SystemsCyber/RemoteRudder/StepperMotorWithEncoder/IMG_7445.JPEG

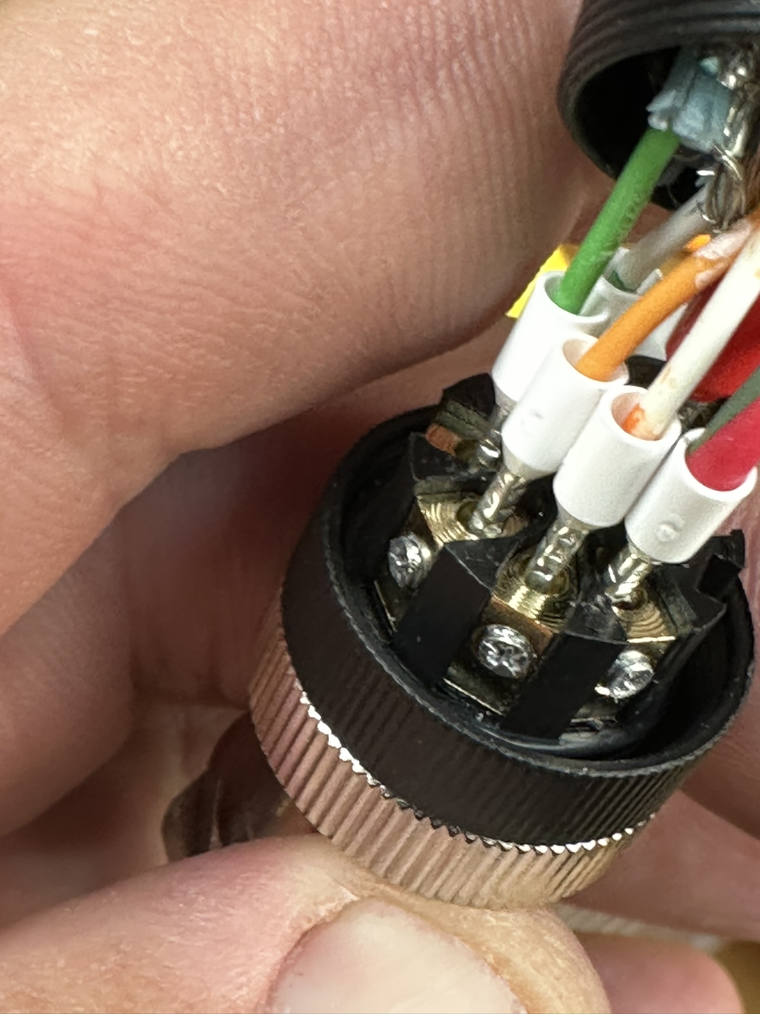
StepperMotorWithEncoder/IMG_7445.JPEG
