SystemsCyber/RemoteRudder/StepperMotorWithEncoder/IMG_7434.JPEG

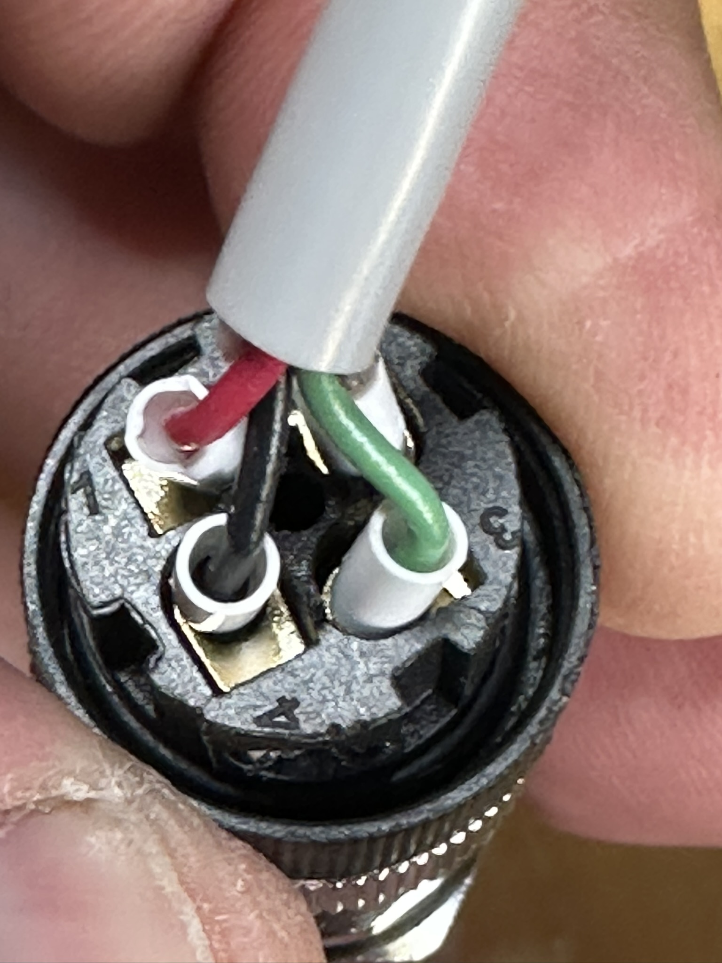
StepperMotorWithEncoder/IMG_7434.JPEG
