SystemsCyber/RemoteRudder/README.md

# RemoteRudder
 Code to control a rudder based autopilot for a ski boat
