SystemsCyber/RemoteRudder/HMI/fullturns.png

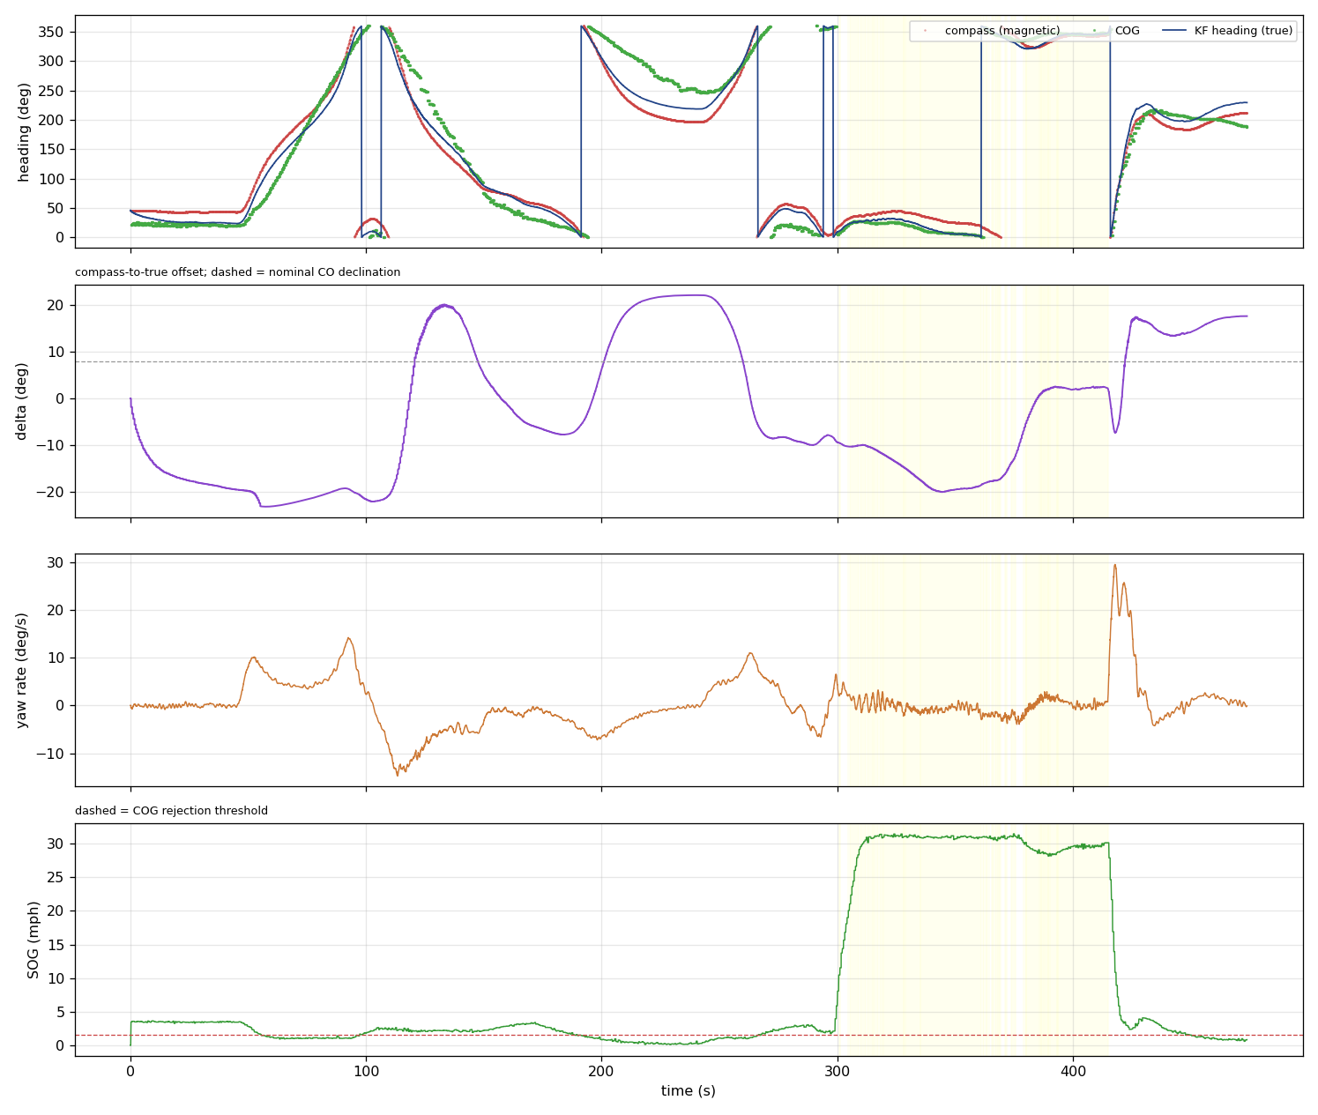
HMI/fullturns.png
