SystemsCyber/RemoteRudder/HMI/trolling.png

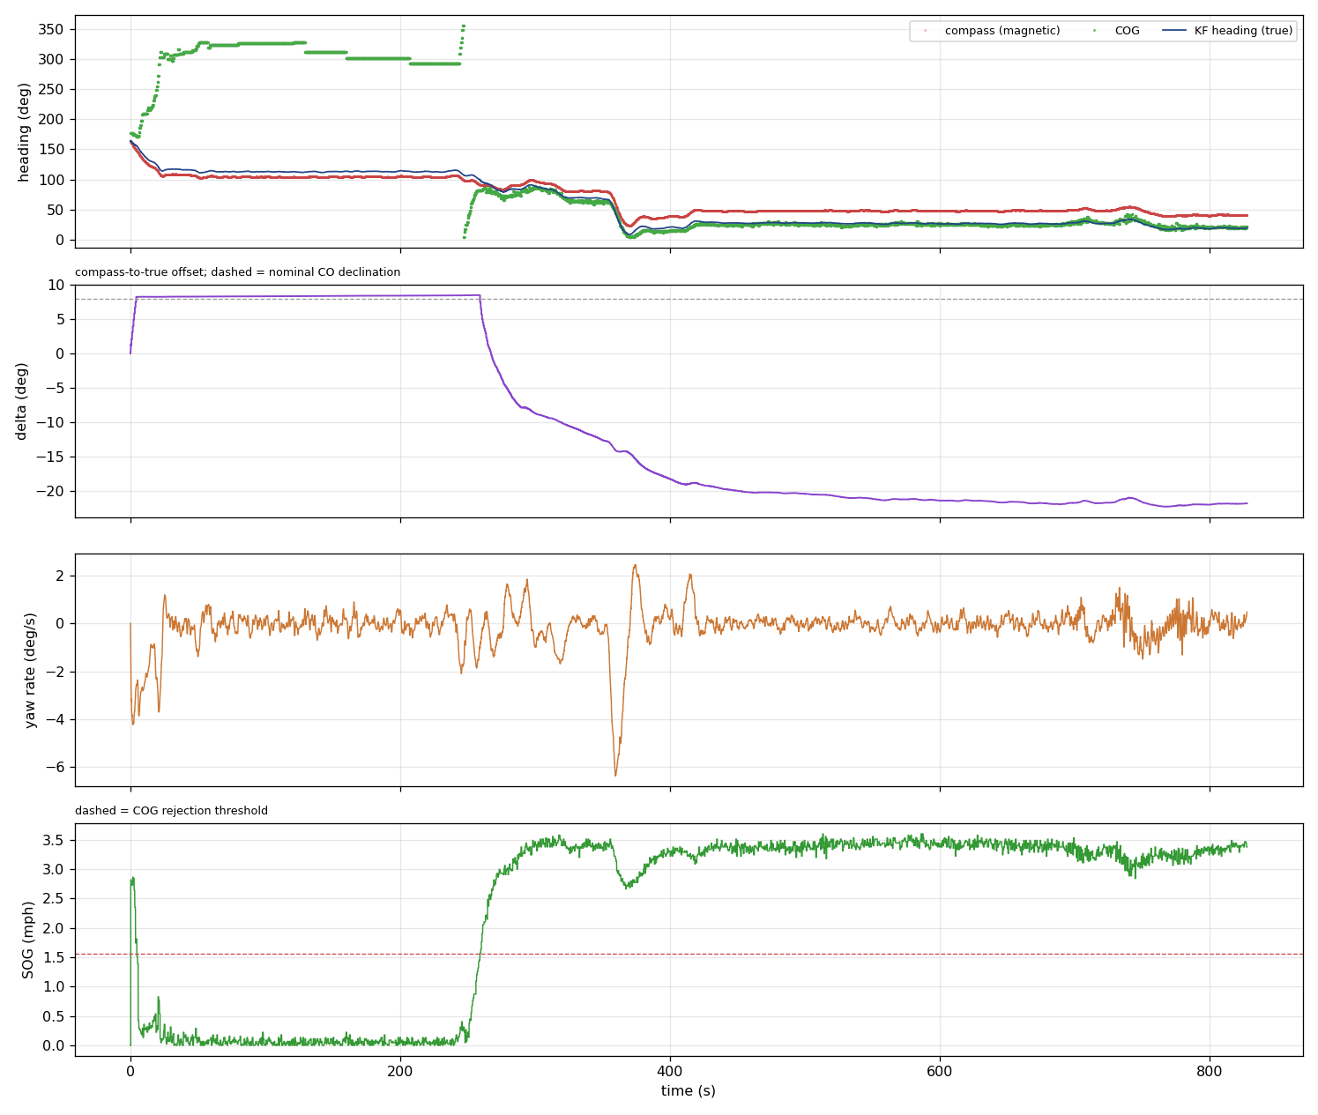
HMI/trolling.png
