SystemsCyber/RemoteRudder/sensor_node/SchematicSensorNode.png

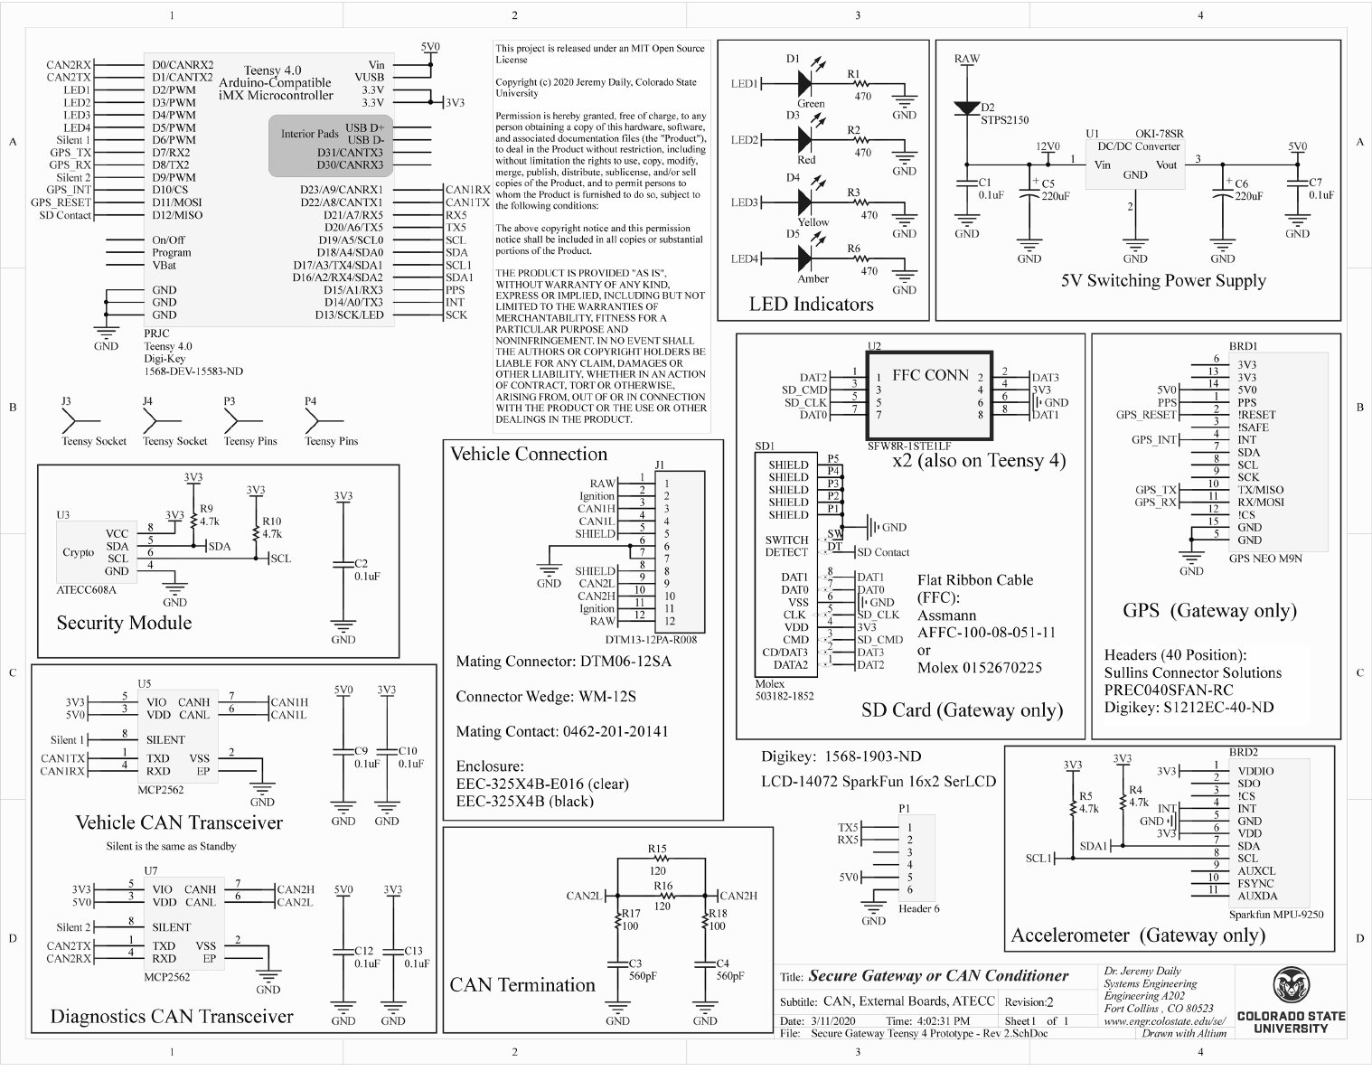
sensor_node/SchematicSensorNode.png
