SystemsCyber/RemoteRudder/StepperMotorWithEncoder/IMG_7435.JPEG

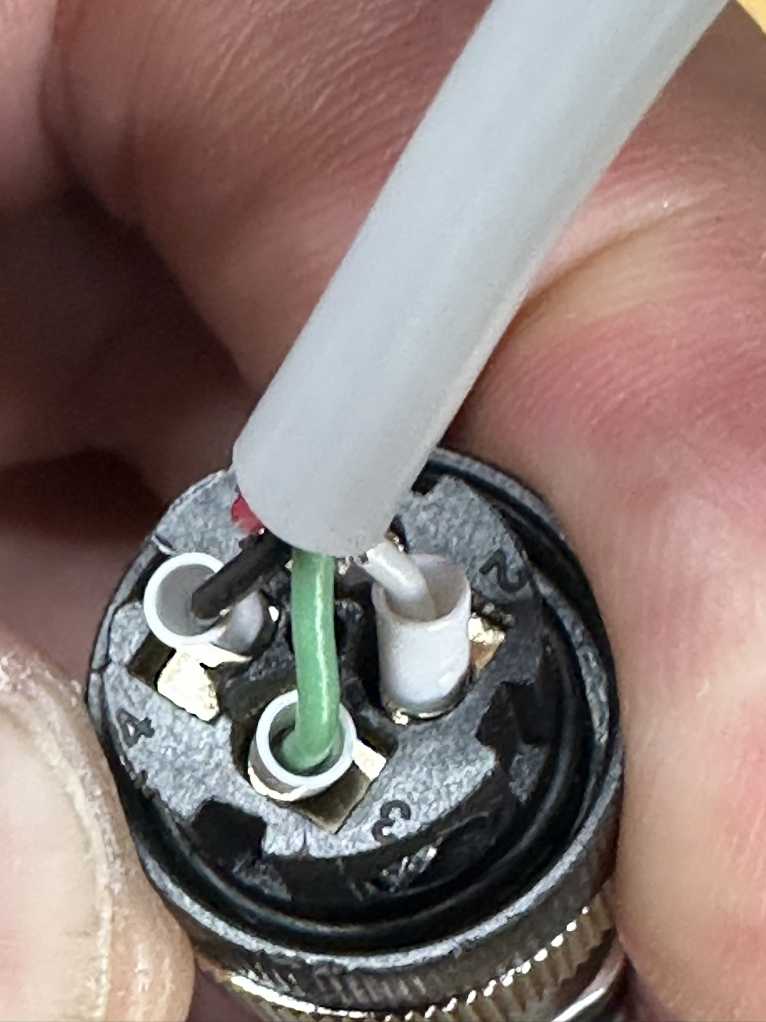
StepperMotorWithEncoder/IMG_7435.JPEG
