SystemsCyber/RemoteRudder/StepperMotorWithEncoder/IMG_7442.JPEG

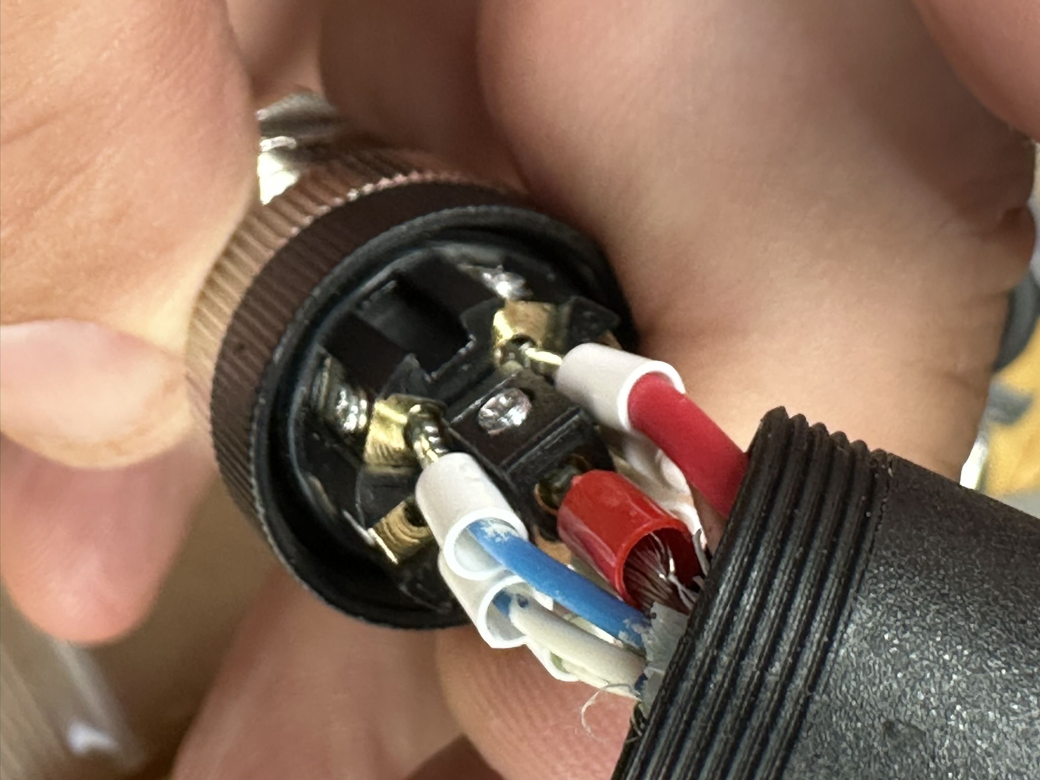
StepperMotorWithEncoder/IMG_7442.JPEG
