SystemsCyber/RemoteRudder/StepperMotorWithEncoder/IMG_7443.JPEG

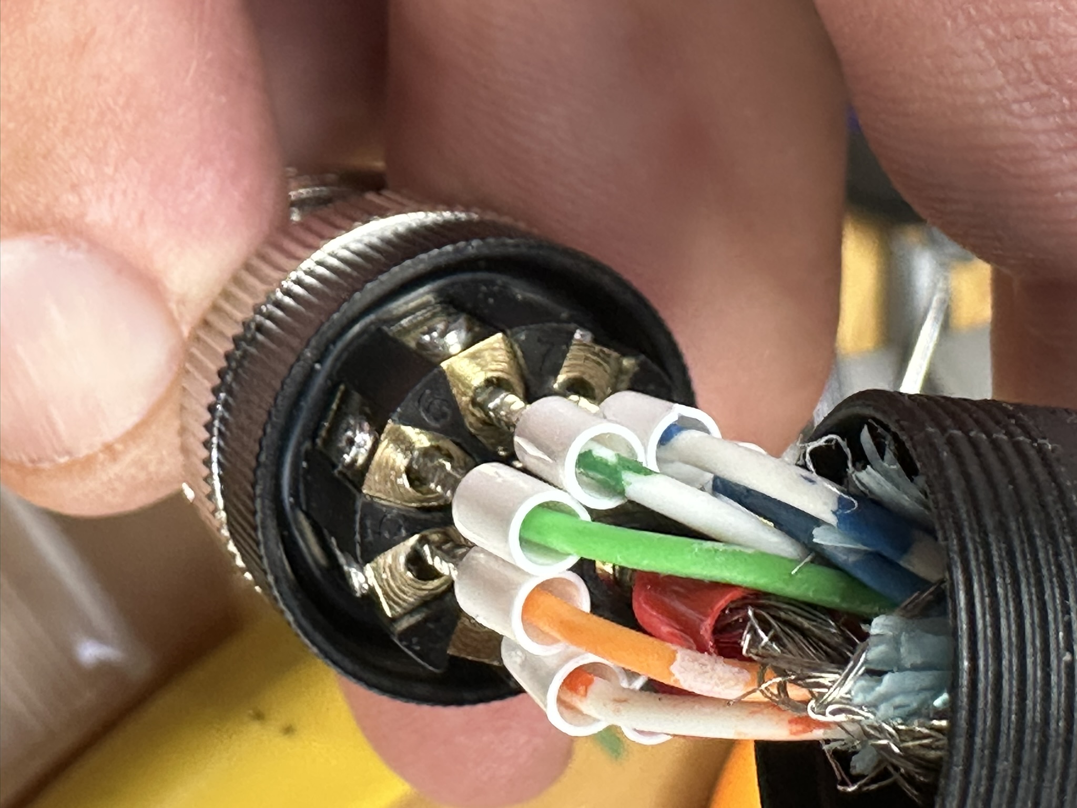
StepperMotorWithEncoder/IMG_7443.JPEG
