SystemsCyber/RemoteRudder/StepperMotorWithEncoder/IMG_7444.JPEG

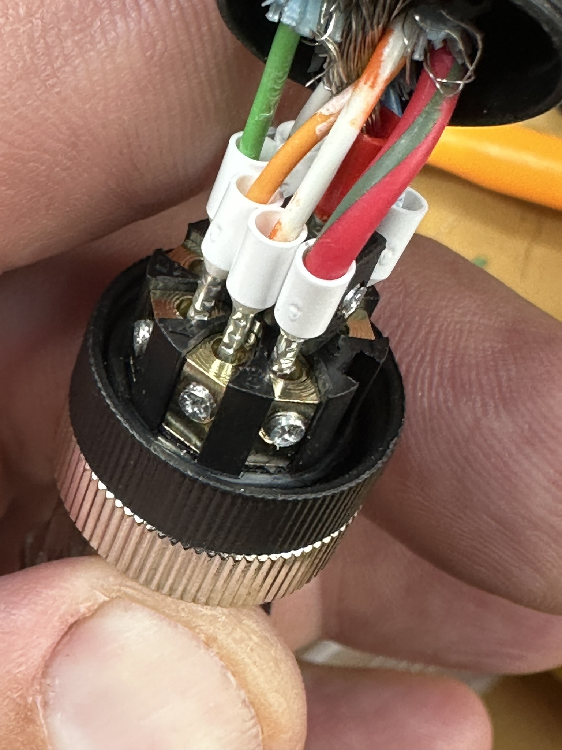
StepperMotorWithEncoder/IMG_7444.JPEG
