SystemsCyber/RemoteRudder/StepperMotorWithEncoder/IMG_7458.JPEG

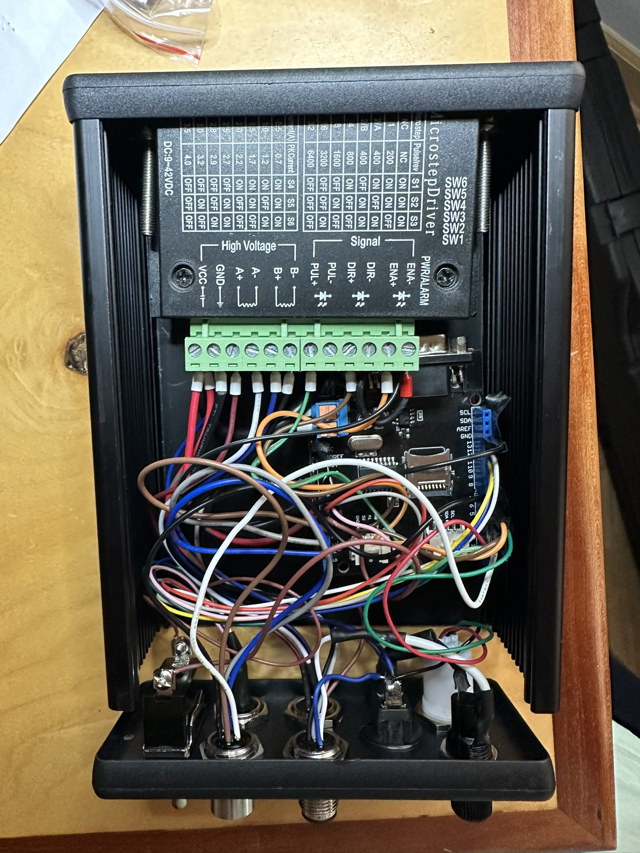
StepperMotorWithEncoder/IMG_7458.JPEG
