SystemsCyber/RemoteRudder/StepperMotorWithEncoder/IMG_7463.JPEG

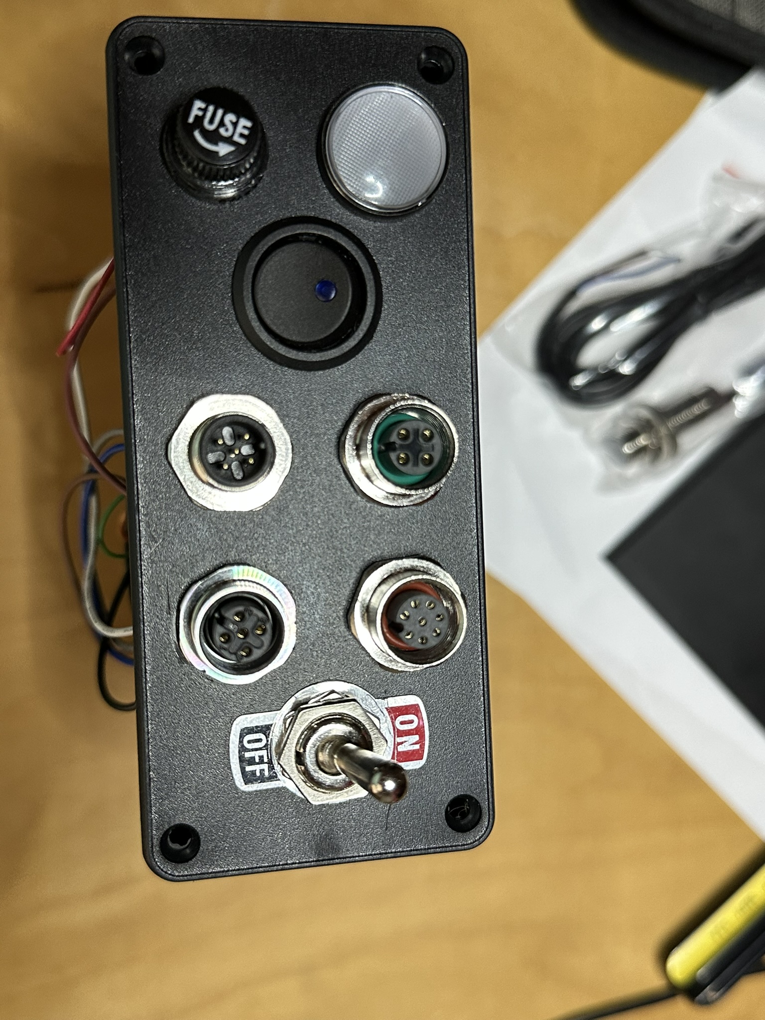
StepperMotorWithEncoder/IMG_7463.JPEG
