SystemsCyber/RemoteRudder/RudderPosition/RudderPosition.ino

/*
Rudder Sensor

The rudder sensor is based on a string potentiometer that extends and retracts with the 
steering cable. The wiper of the string pot is on A4.

Rudder PGN 127245 (0x1F10D)
Default Priority is 2
Default update rate is 100 milliseconds
Destination is Global
Source address is 19, Steering.

The hardware is a Teensy 3.6 with the following connections:
CAN1 has an MCP2562 TXRX
A7 is a red LED
A6 is a green LED
A4 is connected to the wiper of the potentiometer

*/
#include <FlexCAN_T4.h>

FlexCAN_T4<CAN1, RX_SIZE_256, TX_SIZE_16> Can1;
FlexCAN_T4<CAN0, RX_SIZE_256, TX_SIZE_16> Can0;

elapsedMillis output_timer;
const int output_period = 100; //milliseconds

// These constants won't change. They're used to give names to the pins used:
const int analogInPin = A4;  // Analog input pin that the potentiometer is attached to
const long int priority_part = 0x18000000; //Priority 6
const long int pgn_part = 0x01F10D00; //NMEA 2000
const long int source_part = 19; //J1939 SA

const long int CAN_ID = priority_part + pgn_part + source_part;

// NMEA2000 Fields

//Field 1
uint8_t rudder_instance = 0; //Tells which instance of the rudder we are using. 0 = only one.

//Field 2 and 3
uint8_t direction_order = 0b11111111; //Not available

//Field 4
int16_t angle_order = 0xFFFF; //Not available as a command

//Field 5
// Rudder angle where positive values are starboard and negative values are port.
int16_t rudder_position = 0; //range +/1 Pi rad, resolution 1e-4 rad

int sensorValue = 256;        // value read from the pot
int rudder_angle_rad = 0;   // value output to the PWM (analog out)

bool LED_state = HIGH;
CAN_message_t msg;
CAN_message_t msg_rx;

// These constants are determined based on the reading of the potentiometer (pin A4)
// when the rudder is at full stop.
// Determined by watching the serial monitor and manually turning the rudder.
const int full_port_sensor = 549; 
int center_sensor = 331;
const int full_starboard_sensor = 143; 
const int max_center_sensor = 400;
const int min_center_sensor = 260;


// These are the angles (in 1/10000 radians) of the rudder at the full stops.
// We assume zero is in the middle.
//5200 times 1e-4 in radians = 0.52 rad. In degrees, this is 27.79 
const int full_port_out = -5200; 
const int full_starboard_out = 5200; //or center
const int center_out = 0; //or center

// These are the angles in degrees from stop. Use 0.5 degrees per bit with -60 to +60 for the range.
// We assume 128 is in the middle.
const uint8_t full_port_out_deg = 128 - 120;  // this is more for the visual than reality 
const uint8_t full_starboard_out_deg = 128 + 120; //or center
const uint8_t center_out_deg = 128; //or center


static int maxSensorValue = 256;
static int minSensorValue = 256;
static uint8_t rudderDegrees;
static uint8_t counter = 0;

void setup() {
  pinMode(LED_BUILTIN, OUTPUT); digitalWrite(LED_BUILTIN, HIGH); 
  pinMode(6, OUTPUT); digitalWrite(6, LOW); /* optional tranceiver enable pin */
 
  Can1.begin();
  Can1.setBaudRate(250000);
  Can1.setMaxMB(16);
  Can1.enableFIFO();
  Can1.enableFIFOInterrupt();
  Can1.onReceive(canSniff);
  
  Can0.begin();
  Can0.setBaudRate(250000);
  Can0.setMaxMB(16);
  Can0.enableFIFO();
  Can0.enableFIFOInterrupt();
  Can0.onReceive(canSniff);
  
  msg.flags.extended = 1;
  msg.len = 8;
  msg.id = CAN_ID;
    
}

void canSniff(const CAN_message_t &msg_rx) {
  LED_state = !LED_state;
  digitalWrite(LED_BUILTIN, LED_state);
  if (msg_rx.id == 0x19EF19F9){ //update center trim value
    int new_center_sensor = (msg_rx.buf[0]) + (int(msg_rx.buf[1]) >> 8);
    if (new_center_sensor < max_center_sensor && new_center_sensor > min_center_sensor){
      center_sensor = new_center_sensor;
    }
  }
}

void loop() {
  // read the analog in value:
  sensorValue = analogRead(analogInPin);
  if (sensorValue > 0 ){
    if (sensorValue > maxSensorValue) maxSensorValue = sensorValue;
    if (sensorValue < minSensorValue) minSensorValue = sensorValue;
  }
  // map it to the range defined in NMEA 2000:
  // Since the string is not perfectly flat, the different angles had geometric non-linearities
  // Therefore, we'll correct these using a 2 segment line.
  if (sensorValue < center_sensor){
    rudder_angle_rad = map(sensorValue, center_sensor, full_starboard_sensor, center_out, full_starboard_out);
    rudderDegrees = map(sensorValue, center_sensor, full_starboard_sensor, center_out_deg, full_starboard_out_deg);
  }
  else{
    rudder_angle_rad = map(sensorValue, full_port_sensor, center_sensor, full_port_out, center_out);
    rudderDegrees = map(sensorValue, center_sensor, full_port_sensor, center_out_deg, full_port_out_deg);
  }
  
  Can1.events();
  Can0.events();

  if ( output_timer >= output_period  ) {
    output_timer = 0;
    
    msg.buf[0] = counter++;
    msg.buf[1] = (sensorValue & 0xFF   );
    msg.buf[2] = (sensorValue & 0xFF00 ) >> 8;
    msg.buf[3] = (maxSensorValue & 0xFF   );
    msg.buf[4] = (maxSensorValue & 0xFF00 ) >> 8;
    msg.buf[5] = (minSensorValue & 0xFF   );
    msg.buf[6] = (minSensorValue & 0xFF00 ) >> 8;
    msg.buf[7] = rudderDegrees;
    
    Can1.write(msg);
    Can0.write(msg);
    
  }
}
