SystemsCyber/RemoteRudder/TUI/tests/test_integration.py

"""
Integration tests: bridge mapping, live server, phone/TUI goal sync.

The server tests spawn a real Tornado process on a free port and talk to it
over HTTP and WebSocket. That is slower than calling handlers directly, but
it is the only way to catch the things that actually break: JSON that will not
serialize, a handler that raises on malformed input, a snapshot key the browser
depends on quietly disappearing.
"""

from __future__ import annotations

import json
import subprocess
import sys
import time
import urllib.error
import urllib.request
from pathlib import Path

import pytest

HMI_DIR = Path(__file__).resolve().parent.parent


# ---------------------------------------------------------------------------
# Bridge mapping
# ---------------------------------------------------------------------------


class TestBridgeMapping:
    def test_maps_decoded_keys_to_signals(self, bridge, state):
        bridge.on_decoded({"compass_heading": 100.0, "SOG": 5.0, "COG": 95.0})
        assert state.signal_value("compass_heading") == pytest.approx(100.0)
        assert state.signal_value("sog") == pytest.approx(5.0)
        assert state.signal_value("cog") == pytest.approx(95.0)

    def test_unknown_keys_ignored_not_raised(self, bridge, state):
        """A decoder growing a new field must not crash the HMI."""
        bridge.on_decoded({"brand_new_field": 42, "compass_heading": 100.0})
        assert state.signal_value("compass_heading") == pytest.approx(100.0)

    def test_none_values_do_not_overwrite(self, bridge, state):
        bridge.on_decoded({"compass_heading": 100.0})
        bridge.on_decoded({"compass_heading": None})
        assert state.signal_value("compass_heading") == pytest.approx(100.0)

    def test_malformed_payload_is_contained(self, bridge, state):
        """
        This runs on the CAN read path. An exception here would kill the
        reader thread and silently freeze the whole display.
        """
        bridge.on_decoded({"compass_heading": object()})  # not floatable
        kinds = [k for _, k, _ in state.recent_events(10)]
        assert "WARN" in kinds

    def test_timeout_notifications_skipped(self, bridge, state):
        bridge.on_decoded({"timeout": True, "source_id": 0x123, "steering": None})
        assert state.signal_value("steering_angle") is None

    def test_control_state_from_status_frame(self, bridge, state):
        bridge.on_decoded(
            {
                "autopilot_engaged": True,
                "left_turn": False,
                "right_turn": True,
                "heading_error": -3.5,
            }
        )
        assert state.autopilot_engaged is True
        assert state.right_turn is True
        assert state.heading_error == pytest.approx(-3.5)

    def test_filter_output_routed(self, bridge, state, monitor):
        """The seam the Kalman filter will plug into."""
        bridge.on_decoded({"fused_heading": 123.4, "heading_sigma": 1.5, "yaw_rate": -2.0})
        assert state.signal_value("fused_heading") == pytest.approx(123.4)
        assert state.signal_value("yaw_rate") == pytest.approx(-2.0)

    def test_registers_all_watched_sources(self, bridge, state):
        from hmi_bridge import WATCHED

        assert set(state.sources.keys()) == set(WATCHED.keys())
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
