SystemsCyber/RemoteRudder/(commit log)

2023-08-06 Added Rudder Sensing
2025-07-08 Finished Steering Wheel Motor and Encoder
    [WiringDiagramForStepperMotorController.xlsx]
2025-07-15 Updated Rudder Position
2025-07-15 Updated Rudder Position with Data
2025-07-15 Update Encoder with Enable
2025-07-16 Limit the rudder from over spinning.
2025-07-19 Autopilot button toggles
2025-07-19 Autopilot Makes Motor Turn
2025-07-20 Changed Shaft range parameters
2025-07-21 Reflect Actual steering values
2025-07-23 removed rudder buttons
2025-08-06 Buttons working
2025-08-06 Exit button working
2025-08-15 Working virtual CAN
    [autopilot_log_20250812_180948.csv]
2026-07-27 Many rounds with CLAUDE on a parked boat
    [autopilot_log_20260725_104724.csv, autopilot_log_20260725_104726.csv, autopilot_log_20260725_104727.csv, autopilot_log_20260725_104731.csv, autopilot_log_20260725_104734.csv, autopilot_log_20260725_104736.csv, autopilot_log_20260725_104738.csv, autopilot_log_20260725_104741.csv]
2026-07-27 Removed Logs
    [autopilot_log_20260725_104724.csv, autopilot_log_20260725_104726.csv, autopilot_log_20260725_104727.csv, autopilot_log_20260725_104731.csv, autopilot_log_20260725_104734.csv, autopilot_log_20260725_104736.csv, autopilot_log_20260725_104738.csv, autopilot_log_20260725_104741.csv]
